rlacksals0618-collab/env-dashboard/firmware/P01/pins.h

#pragma once
#include <Arduino.h>
#define PROFILE_ID "P01"
const byte PIN_LED = 8;
const byte PIN_BUTTON = 2;
const byte PIN_POT = A0;
const byte PIN_LIGHT = A1;
const byte PIN_DHT = 4;
const byte PIN_SDA = A4;
const byte PIN_SCL = A5;
